Johan-Campo/BJT-Amplificador-Audio-Multietapa/(commit log)

2026-03-15 Revise README with project details and specifications
    Updated project title and added detailed sections on system specifications, amplifier architecture, circuit schematic, time-domain simulation, frequency response, and SPICE netlist.
2026-03-16 Improve README with detailed circuit analysis
    Enhanced README with additional details on frequency response, operating point, and circuit analysis.
