Johan-Campo/BJT-Amplificador-Audio-Multietapa/(notices)

Notices in the files:
README.md:
License: MIT
